karagiancode/small_actuator/cad/step/small_actuator.step

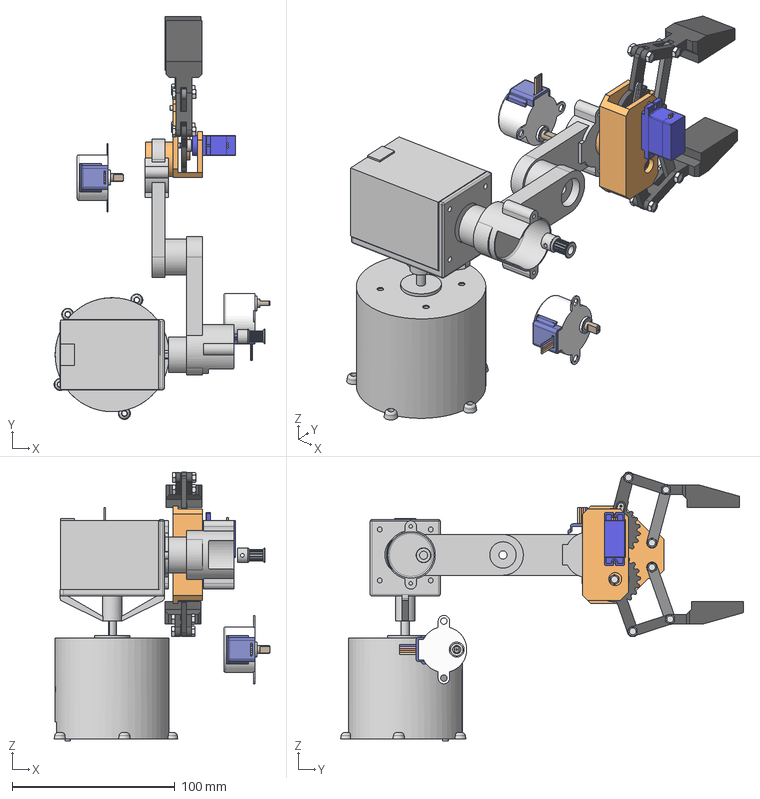
[picture p2: CAD file, 2026-10-14]
cad/step/small_actuator.step
132.5 x 247.3 x 164.9 mm
