karagiancode/small_actuator/cad/stl/L1.stl

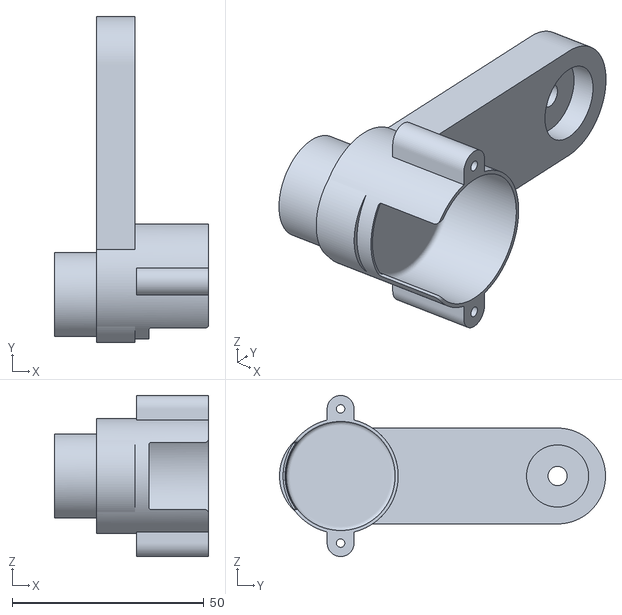
[picture p3: CAD file, 2026-10-14]
cad/stl/L1.stl
40.2 x 85.0 x 42.0
