karagiancode/small_actuator/cad/stl/L2.stl

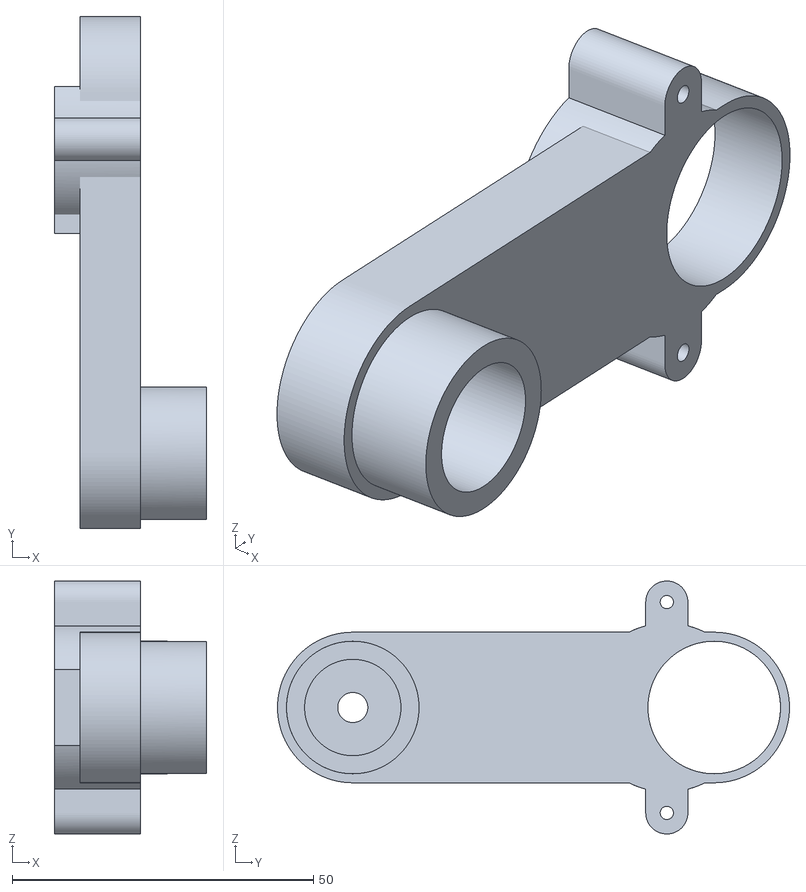
[picture p4: CAD file, 2026-10-14]
cad/stl/L2.stl
25.3 x 85.0 x 42.0
