karagiancode/small_actuator/cad/stl/gamma-nema17.stl

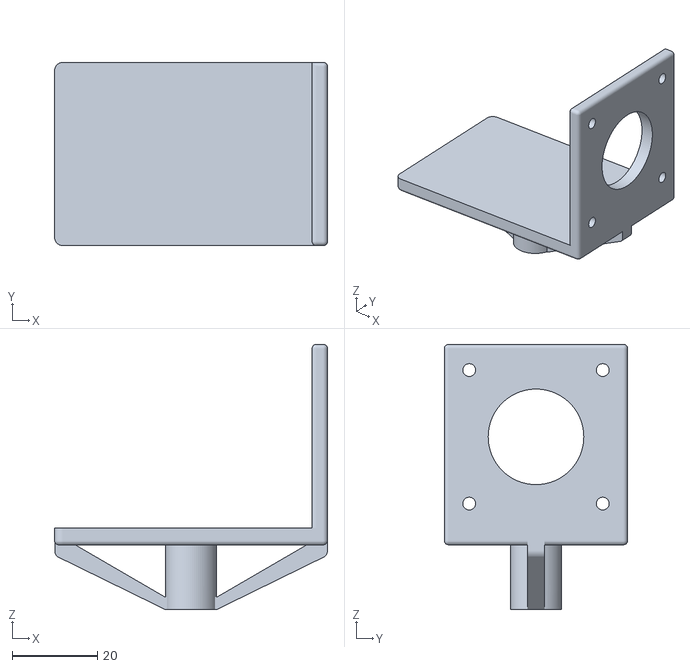
[picture p5: CAD file, 2026-10-14]
cad/stl/gamma-nema17.stl
64.0 x 43.0 x 62.2
