karagiancode/small_actuator/cad/stl/grabberbase.stl

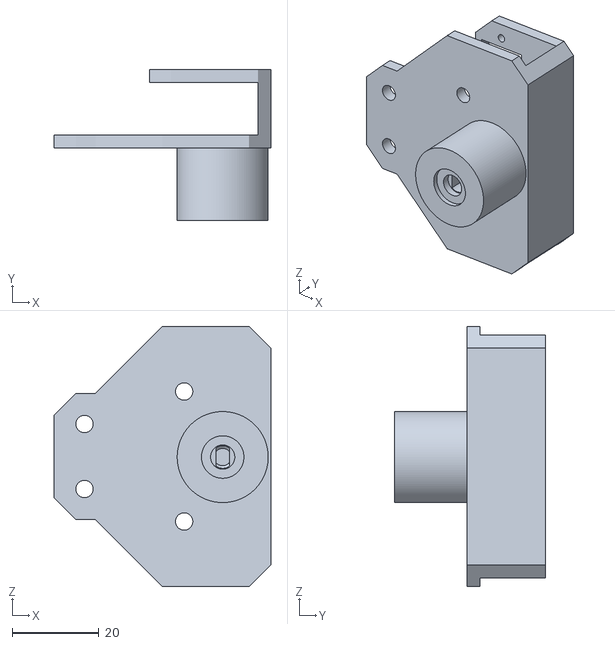
[picture p6: CAD file, 2026-10-14]
cad/stl/grabberbase.stl
50.0 x 34.9 x 60.0
