karagiancode/small_actuator/cad/stl/base.stl

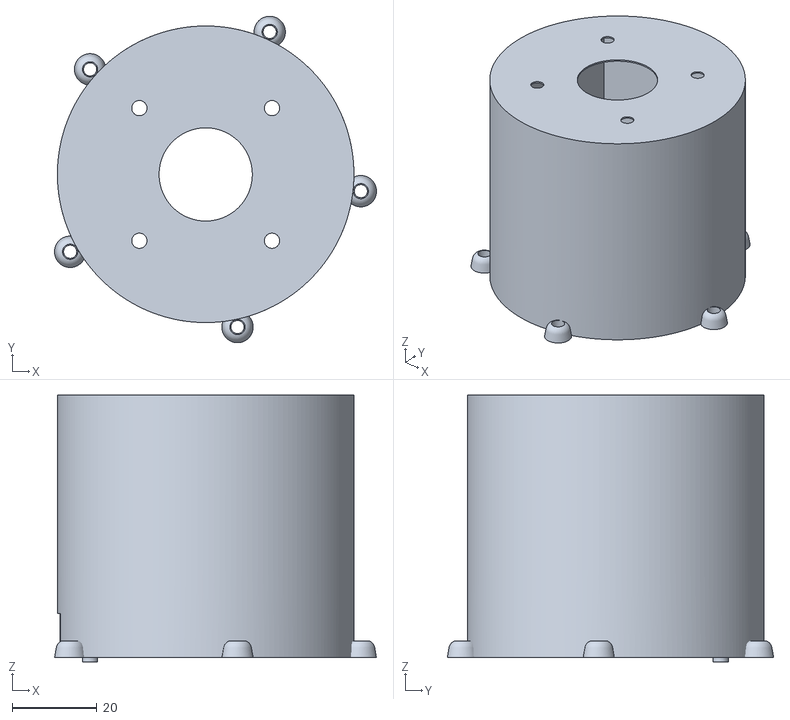
[picture p7: CAD file, 2026-10-14]
cad/stl/base.stl
76.0 x 77.1 x 63.0
