karagiancode/small_actuator/(list of files, cad)

Other CAD files:
cad/fusion/grabber.f3d
