karagiancode/small_actuator/hardware/wiring/wiring-diagram.png

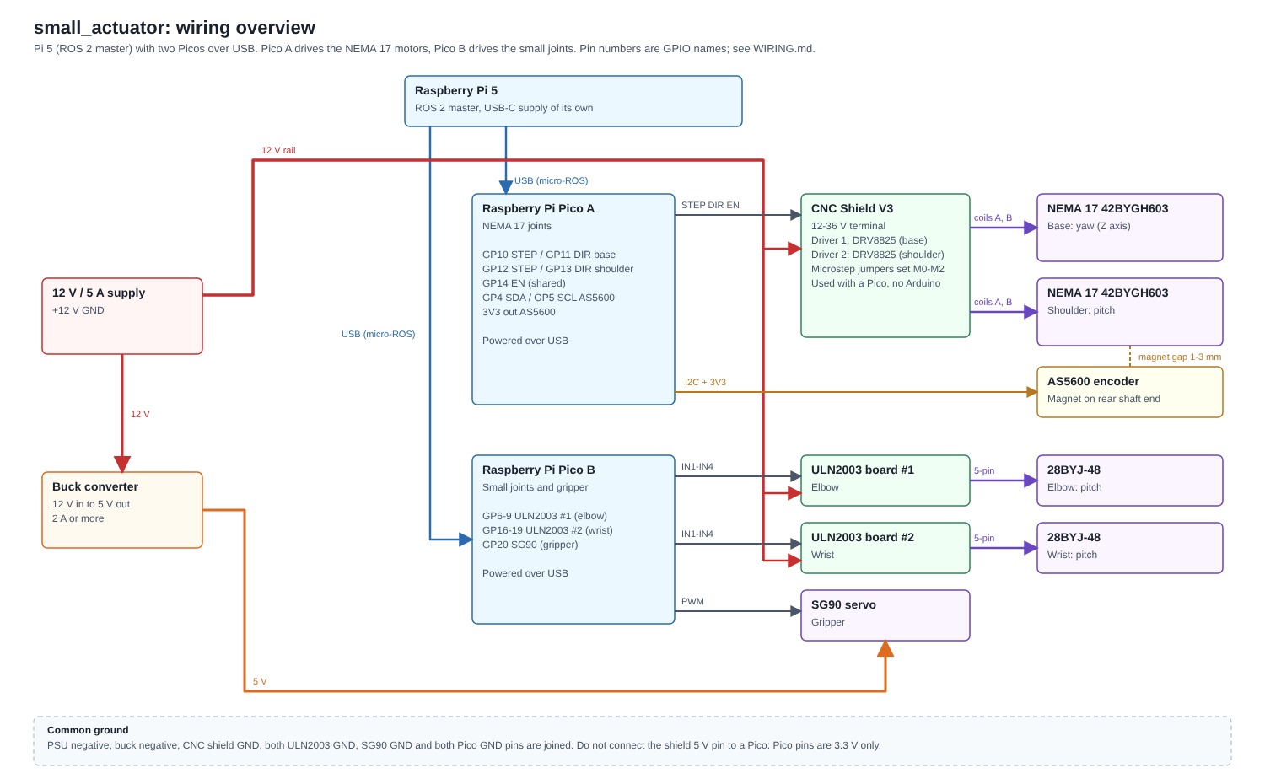
hardware/wiring/wiring-diagram.png
