karagiancode/small_actuator/(commit log)

2026-10-14 Organize CAD files and add project README
    Claude-Session: https://claude.ai/code/session_01LXUMxAwN8X6Q7JEHc2q8N4
    [L1.stl, L2.stl, base.stl, gamma-nema17.stl, grabber.f3d, grabberbase.stl, small_actuator.step]
2026-10-14 Add bill of materials
    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
    [bom.csv]
2026-10-14 Update BOM: per-unit prices, add controllers, encoder and power parts
    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
    [bom.csv]
2026-10-14 Add wiring diagram and pinout; update BOM power rows
    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
    [bom.csv]
2026-10-14 Rework wiring for CNC shield and split Picos by joint type
    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
    [bom.csv]
